MyNameIsTobi/ESP32_TestBoard/Esp32.kicad_pcb

## KiCad design Esp32.kicad_pcb (2026-06-08)

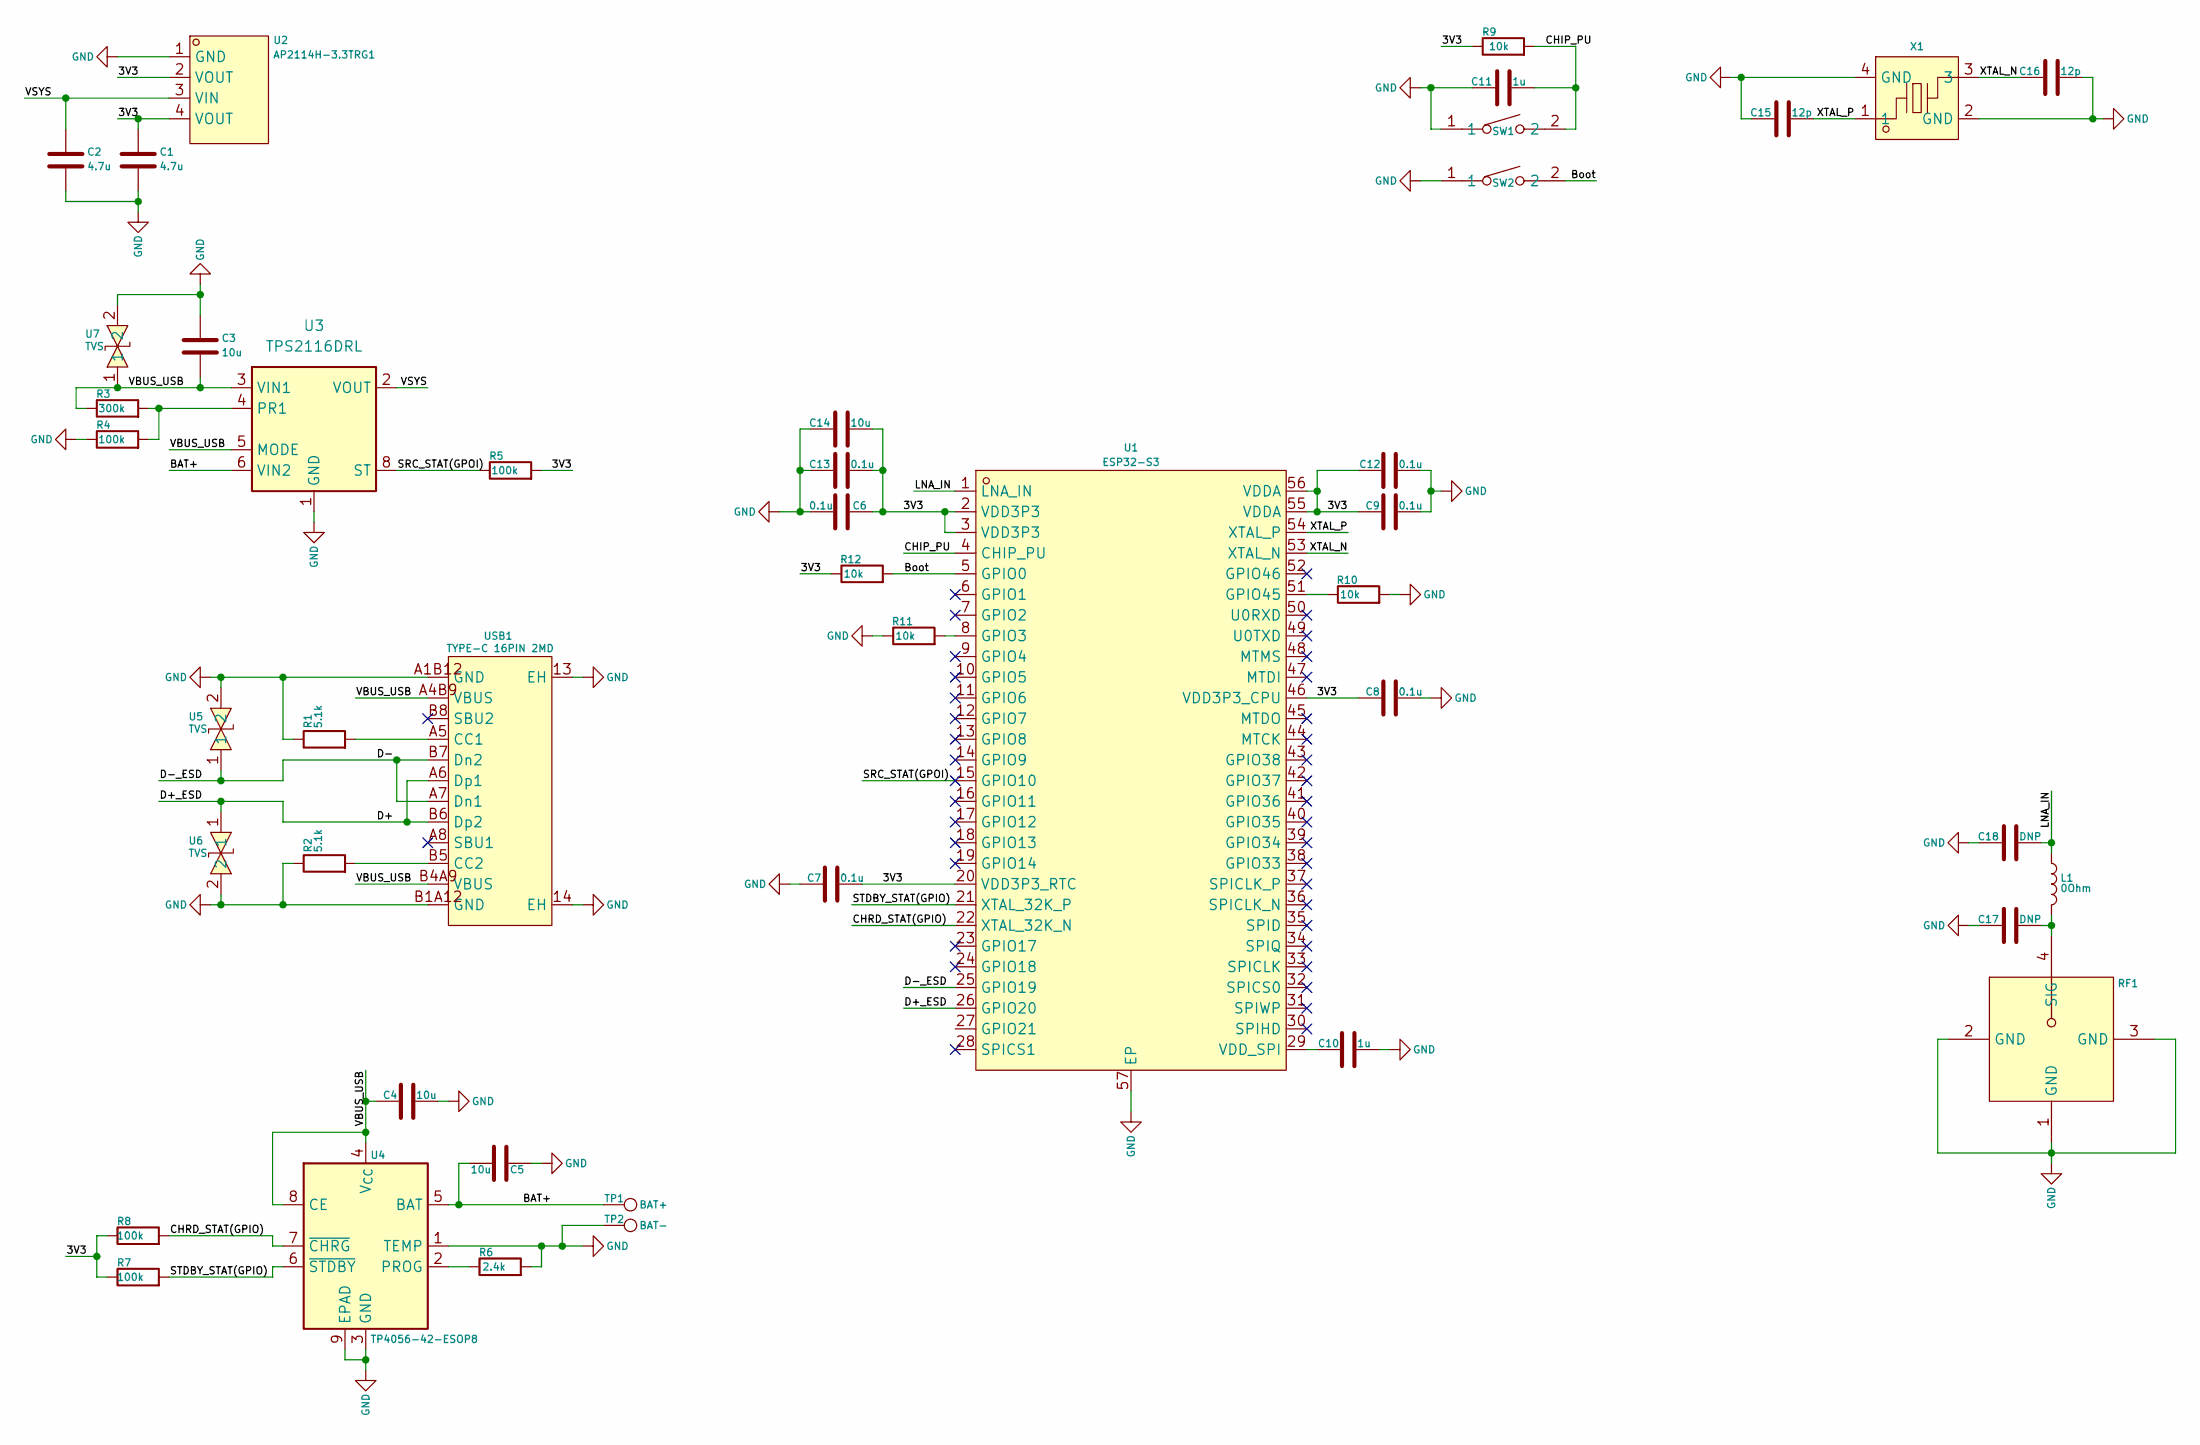
[picture p1: schematic Esp32.kicad_sch]

Parts:
C1, C2: 4.7u; C_0402_1005Metric
C3, C4, C5, C14: 10u; C_0402_1005Metric
C6, C7, C8, C9, C12, C13: 0.1u; C_0402_1005Metric
C10, C11: 1u; C_0402_1005Metric
C15, C16: 12p; C_0402_1005Metric
C17, C18: DNP; C_0402_1005Metric
L1: 0Ohm; R_0402_1005Metric
R1, R2: 5.1k; R_0402_1005Metric
R3: 300k; R_0402_1005Metric
R4, R5, R7, R8: 100k; R_0402_1005Metric
R6: 2.4k; R_0402_1005Metric
R9, R10, R11, R12: 10k; R_0402_1005Metric
RF1: KH-IPEX-K501-29; ANT-SMD_KH-IPEX-K501-29; MPN KH-IPEX-K501-29; LCSC Part C411563
SW1, SW2: TS-1088-AR02016; SW-SMD_L3.9-W3.0-P4.45; MPN TS-1088-AR02016; LCSC Part C720477
TP1: BAT+; TestPoint_Pad_D1.5mm
TP2: BAT-; TestPoint_Pad_D1.5mm
U1: ESP32-S3; QFN-56_L7.0-W7.0-P0.40-TL-EP4.0; MPN ESP32-S3FN8; LCSC Part C2913196
U2: AP2114H-3.3TRG1; SOT-223_L6.7-W3.5-P2.30-BR; MPN AP2114H-3.3TRG1; LCSC Part C150716
U3: TPS2116DRL; SOT-583-8
U4: TP4056-42-ESOP8; SOIC-8-1EP_3.9x4.9mm_P1.27mm_EP2.41x3.3mm_ThermalVias
U5, U6, U7: TVS; D0402-BI; MPN RCLAMP0521P.TCT-MS; LCSC Part C3029033
USB1: TYPE-C 16PIN 2MD; USB-C-SMD_TYPE-C-16PIN-2MD-073; MPN TYPE-C 16PIN 2MD(073); LCSC Part C2765186
X1: XTM32040000DT00351001; CRYSTAL-SMD_4P-L3.2-W2.5-BL-2; MPN XTM32040000DT00351001; LCSC Part C42464324

Connections:
/3V3: C1.1, C6.1, C7.1, C8.2, C9.2, C12.2, C13.1, C14.1, R5.2, R7.1, R8.1, R9.1, R12.1, U1.2 (VDD3P3), U1.3 (VDD3P3), U1.20 (VDD3P3_RTC), U1.46 (VDD3P3_CPU), U1.55 (VDDA), U1.56 (VDDA), U2.2 (VOUT), U2.4 (VOUT)
/BAT+: C5.1, TP1.1 (1_1), U3.6 (VIN2), U4.5 (BAT)
/Boot: R12.2, SW2.2, U1.5 (GPIO0)
/CHIP_PU: C11.1, R9.2, SW1.2, U1.4 (CHIP_PU)
/CHRD_STAT(GPIO): R8.2, U1.22 (XTAL_32K_N), U4.7 (~CHRG)
/D+: U1.26 (GPIO20), U6.1, USB1.A6 (Dp1), USB1.B6 (Dp2)
/D-: U1.25 (GPIO19), U5.1, USB1.A7 (Dn1), USB1.B7 (Dn2)
/LNA_IN: C18.1, L1.1, U1.1 (LNA_IN)
/SRC_STAT(GPOI): R5.1, U1.15 (GPIO10), U3.8 (ST)
/STDBY_STAT(GPIO): R7.2, U1.21 (XTAL_32K_P), U4.6 (~STDBY)
/VBUS_USB: C3.2, C4.2, R3.1, U3.3 (VIN1), U3.5 (MODE), U4.4 (V_{CC}), U4.8 (CE), U7.1, USB1.A4B9 (VBUS), USB1.B4A9 (VBUS)
/VSYS: C2.1, U2.3 (VIN), U3.2 (VOUT), U3.7 (VOUT)
/XTAL_N: C16.2, U1.53 (XTAL_N), X1.3
/XTAL_P: C15.1, U1.54 (XTAL_P), X1.1
GND: C1.2, C2.2, C3.1, C4.1, C5.2, C6.2, C7.2, C8.1, C9.1, C10.1, C11.2, C12.1, C13.2, C14.2, C15.2, C16.1, C17.2, C18.2, R1.1, R2.1, R4.1, R6.2, R10.2, R11.1, RF1.1 (GND), RF1.2 (GND), RF1.3 (GND), SW1.1, SW2.1, TP2.1 (1_1), U1.57 (EP), U2.1 (GND), U3.1 (GND), U4.1 (TEMP), U4.3 (GND), U4.9 (EPAD), U5.2, U6.2, U7.2, USB1.13 (EH), USB1.14 (EH), USB1.A1B12 (GND), USB1.B1A12 (GND), X1.2 (GND), X1.4 (GND)
unnamed: C17.1, L1.2, RF1.4 (SIG)
unnamed: R11.2, U1.8 (GPIO3)
unnamed: R10.1, U1.51 (GPIO45)
unnamed: C10.2, U1.29 (VDD_SPI)
unnamed: R3.2, R4.2, U3.4 (PR1)
unnamed: R6.1, U4.2 (PROG)
unnamed: R1.2, USB1.A5 (CC1)
unnamed: R2.2, USB1.B5 (CC2)

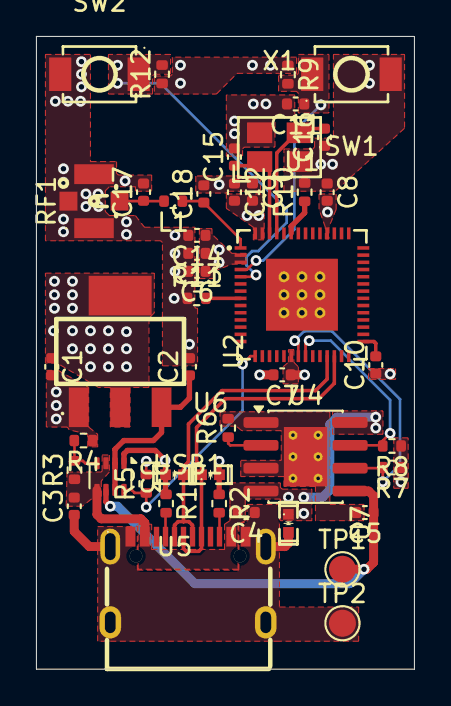
[picture p2: board Esp32.kicad_pcb from above]

Board: 4 copper layers, 21.0 x 35.1 mm, 45 parts (0 on the bottom side), 23 nets.
