MyNameIsTobi/ESP32_TestBoard/(commit log)

2026-05-23 Initial commit: ESP32-S3FN8 test board skeleton
    KiCad project skeleton + gitignore for KiCad workflow.
    Target chip: ESP32-S3FN8 (QFN56, 8MB internal flash).
    [Esp32.kicad_pcb, Esp32.kicad_sch]
2026-05-23 Add ESP32-S3 datasheet + extracted reference DB
    PDF datasheet (v2.2) under datasheets/.
    Quick-lookup markdown reference under reference/, generated by
    4 parallel extraction agents covering pinout, strapping pins,
    electrical/RF specs, and package. Datasheet remains source of truth.
2026-05-29 Add USB-C connector with CC pulldowns + datasheet
    USB1 (TYPE-C 16PIN 2MD) placed and verified via netlist:
    - D+ net: U1.26 (GPIO20) + USB1.A6/B6 (Dp1/Dp2)
    - D- net: U1.25 (GPIO19) + USB1.A7/B7 (Dn1/Dn2)
    - CC1/CC2 pulled down via R1/R2 (5.1k each) to GND
    - GND on shield (13/14), A1B12, B1A12, U1.57 EP
    Still open at USB block: VBUS feed to LDO, ESD protection on D+/D-.
    Datasheets/ PDF added (was missing from prior commit).
    netlist.xml + erc.txt gitignored as regenerated artifacts.
    [Esp32.kicad_sch]
2026-06-04 kicad-sync: 2026-06-04T20:56:02Z on Mac
    [Esp32.kicad_pcb, Esp32.kicad_sch]
2026-06-08 kicad-sync: 2026-06-08T04:30:39Z on gaming
    [Esp32.kicad_pcb, Esp32.kicad_sch]
